NiryoRobotics/ned3pro/README.md

# Ned3Pro

This repository contains STL files of the Ned3Pro.

Enjoy !
