NiryoRobotics/ned3pro/6-NED3_PRO_WRIST_ASSEMBLY.step

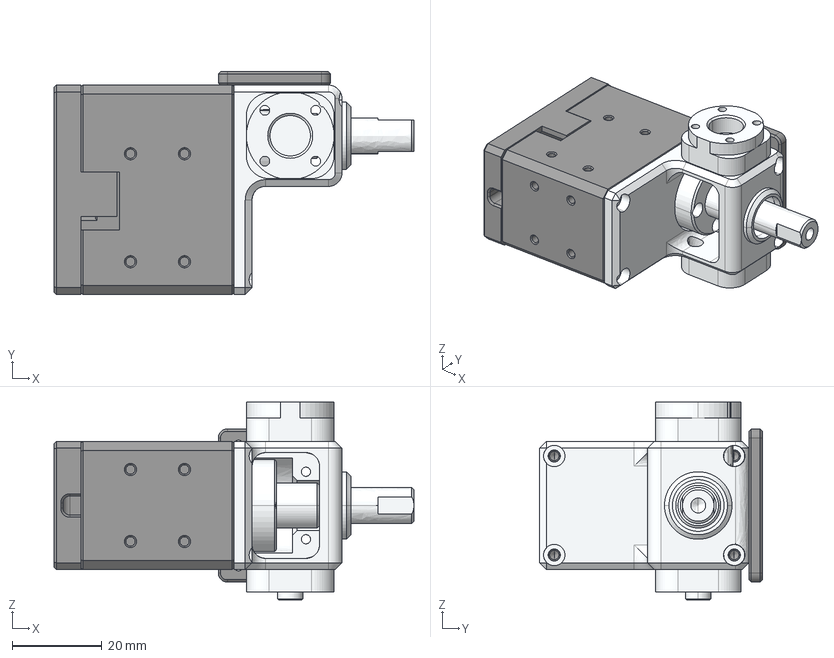
[picture p1: CAD file, 2024-12-11]
6-NED3_PRO_WRIST_ASSEMBLY.step
80.0 x 49.5 x 44.0 mm
10001865-1_SERVO_MOTOR-ROBOTIS-DYNAMIXEL_XH430-W210-T x 9
10001789-1_AXIS-6_XP-430_CAP
10001788-1_AXIS-6_SHAFT
10001787-3_AXIS-6_MOUNT
10001866-2_CAMERA_BASE
