NiryoRobotics/ned3pro/3-NED3_PRO_ARM_ASSEMBLY.step

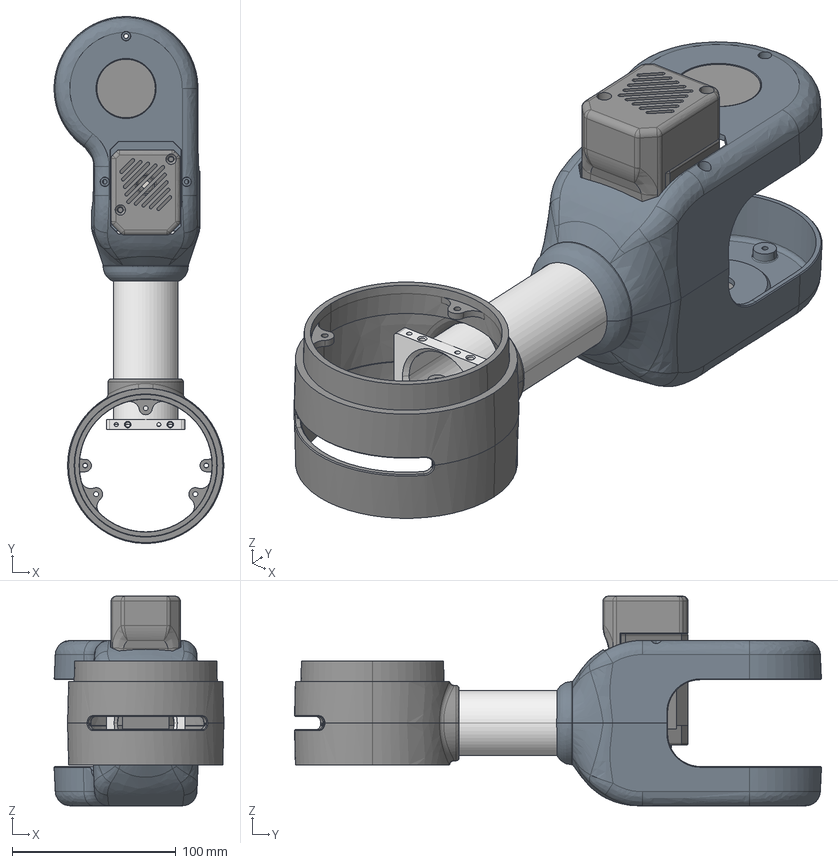
[picture p2: CAD file, 2024-12-11]
3-NED3_PRO_ARM_ASSEMBLY.step
103.7 x 321.9 x 128.0 mm
10001762-2_ARM_TUBE
10001763-1_AXIS-3_RIGHT_SHELL-RAL5011
10001186-1_NEMA 17_87Ncm x 4
10001756-1_AXIS-2b_RIGHT_SHELL-BLACK
10001841-1_STEPPER_SHELL
10001203-1_ROUND_BLACK_STICKER_D37-5 x 2
10001757-1_AXIS-2b_LEFT_SHELL-BLACK
10001764-1_AXIS-3_LEFT_SHELL-RAL5011
