NiryoRobotics/ned3pro/4-NED3_PRO_ELBOW_ASSEMBLY.step

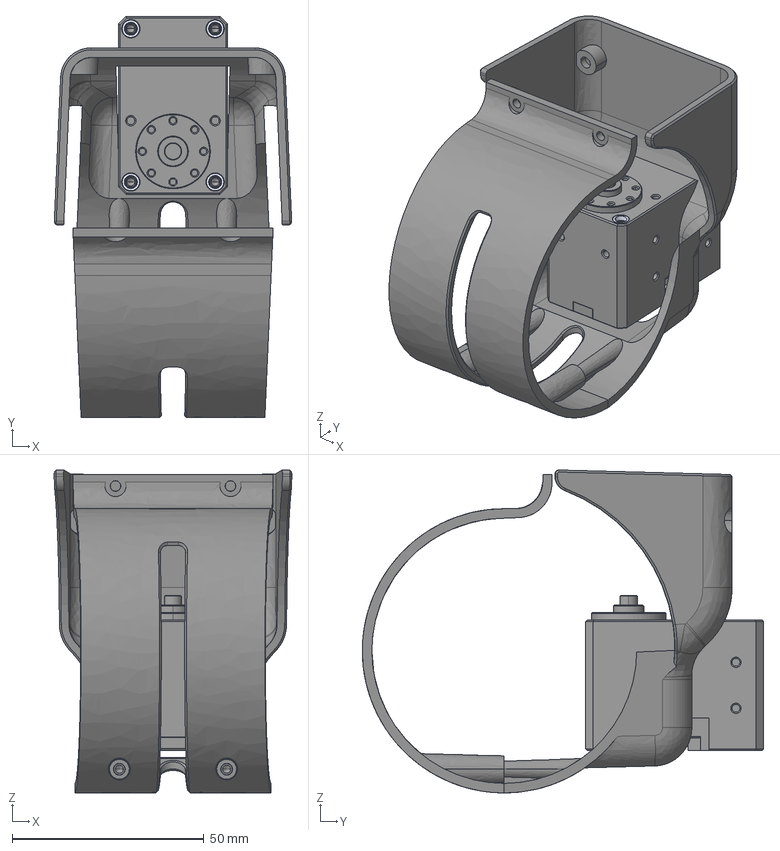
[picture p3: CAD file, 2024-12-11]
4-NED3_PRO_ELBOW_ASSEMBLY.step
62.0 x 104.8 x 84.3 mm
10001865-1_SERVO_MOTOR-ROBOTIS-DYNAMIXEL_XH430-W210-T x 9
10001768-1_AXIS-4a_UPPER_SHELL-RAL9005
10001769-1_AXIS-4a_LOWER_SHELL-RAL9005
