NiryoRobotics/ned3pro/(list of files, cad)

Other CAD files:
stl/2-NED3_PRO_SHOULDER_ASSEMBLY.stl
stl/4-NED3_PRO_ELBOW_ASSEMBLY.stl
stl/6-NED3_PRO_WRIST_ASSEMBLY.stl
